ARL-at-UH/Wave_Flume_DAQ/docs/wave_flume_daq_schematic.pdf

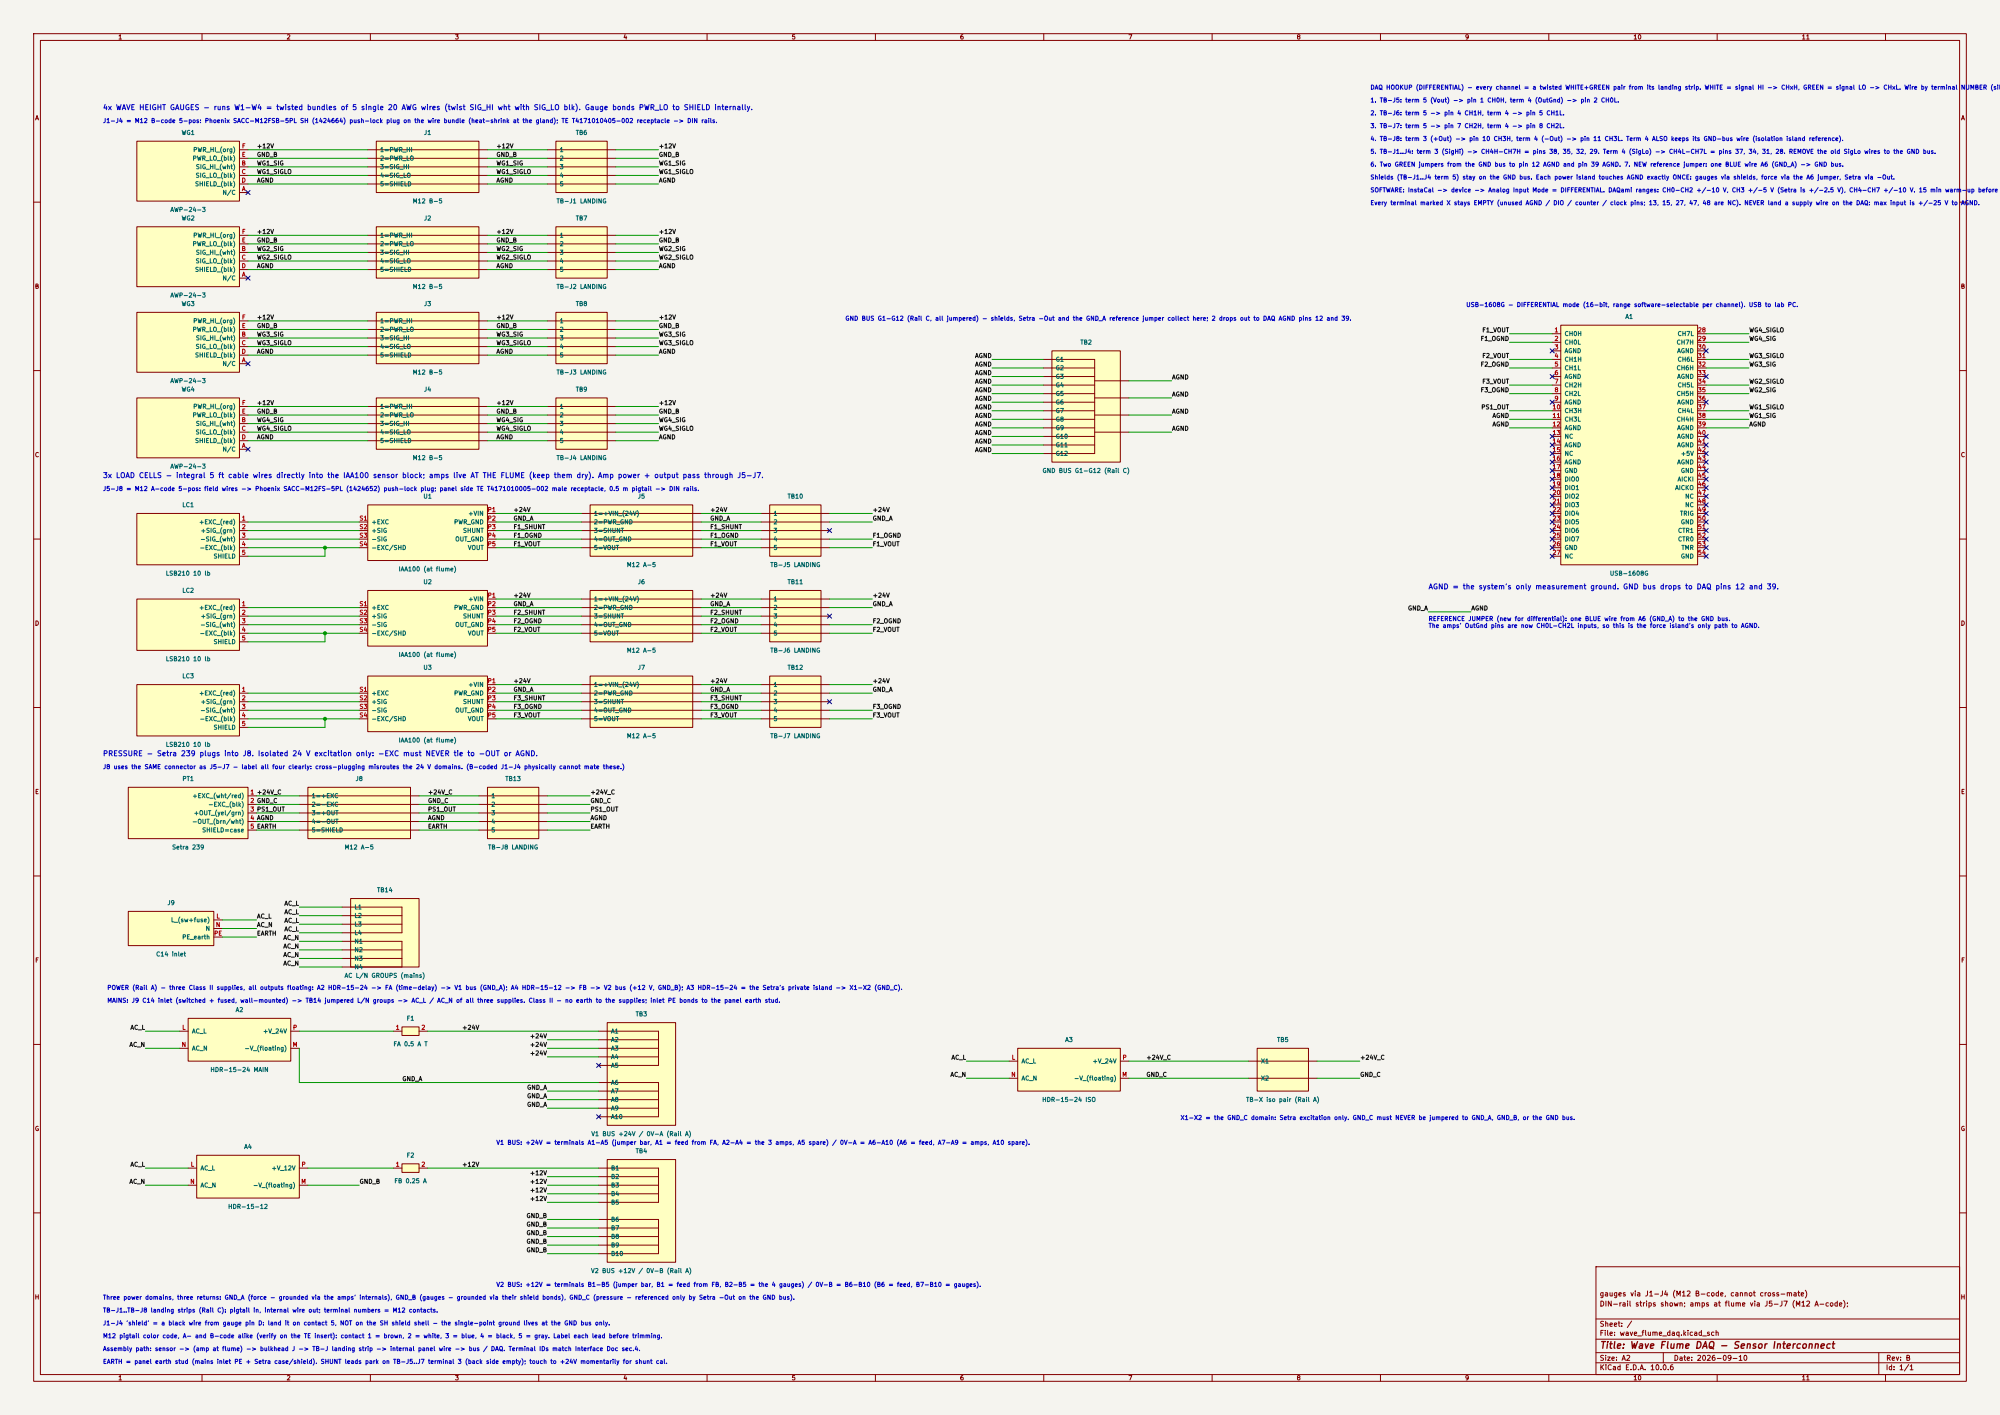
[picture p2: page 1]

Shields (TB-J1..J4 term 5) stay on the GND bus. Each power island touches AGND exactly ONCE: gauges via shields, force via the A6 jumper, Setra via -Out. DAQ HOOKUP (DIFFERENTIAL) - every channel = a twisted WHITE+GREEN pair from its landing strip. WHITE = signal HI -> CHxH, GREEN = signal LO -> CHxL. Wire by terminal NUMBER (silkscreen shows single-ended names).

1. TB-J5: term 5 (Vout) -> pin 1 CH0H, term 4 (OutGnd) -> pin 2 CH0L. 6. Two GREEN jumpers from the GND bus to pin 12 AGND and pin 39 AGND. 7. NEW reference jumper: one BLUE wire A6 (GND_A) -> GND bus.

4x WAVE HEIGHT GAUGES - runs W1-W4 = twisted bundles of 5 single 20 AWG wires (twist SIG_HI wht with SIG_LO blk). Gauge bonds PWR_LO to SHIELD internally.
J1-J4 = M12 B-code 5-pos: Phoenix SACC-M12FSB-5PL SH (1424664) push-lock plug on the wire bundle (heat-shrink at the gland); TE T4171010405-002 receptacle -> DIN rails. 3x LOAD CELLS - integral 5 ft cable wires directly into the IAA100 sensor block; amps live AT THE FLUME (keep them dry). Amp power + output pass through J5-J7.

3. TB-J7: term 5 -> pin 7 CH2H, term 4 -> pin 8 CH2L.

J1 M12 B-5 1=PWR_HI 2=PWR_LO | GND_B | 2

4. TB-J8: term 3 (+Out) -> pin 10 CH3H, term 4 (-Out) -> pin 11 CH3L. Term 4 ALSO keeps its GND-bus wire (isolation island reference).

SOFTWARE: InstaCal -> device -> Analog Input Mode = DIFFERENTIAL. DAQami ranges: CH0-CH2 +/-10 V, CH3 +/-5 V (Setra is +/-2.5 V), CH4-CH7 +/-10 V. 15 min warm-up before calibrated readings. 5. TB-J1..J4: term 3 (SigHi) -> CH4H-CH7H = pins 38, 35, 32, 29. Term 4 (SigLo) -> CH4L-CH7L = pins 37, 34, 31, 28. REMOVE the old SigLo wires to the GND bus. Every terminal marked X stays EMPTY (unused AGND / DIO / counter / clock pins; 13, 15, 27, 47, 48 are NC). NEVER land a supply wire on the DAQ: max input is +/-25 V to AGND.

WG1_SIG

USB-1608G - DIFFERENTIAL mode (16-bit, range software-selectable per channel). USB to lab PC.

J4 M12 B-5 1=PWR_HI 2=PWR_LO | GND_B | 2

WG4_SIG

PRESSURE - Setra 239 plugs into J8. Isolated 24 V excitation only: -EXC must NEVER tie to -OUT or AGND. MAINS: J9 C14 inlet (switched + fused, wall-mounted) -> TB14 jumpered L/N groups -> AC_L / AC_N of all three supplies. Class II - no earth to the supplies; inlet PE bonds to the panel earth stud.

J8 uses the SAME connector as J5-J7 - label all four clearly: cross-plugging misroutes the 24 V domains. (B-coded J1-J4 physically cannot mate these.)

PS1_OUT +24V_C GND_C | J8 M12 A-5 2=-EXC | PS1_OUT GND_C | 2 | GND_C +24V_C

AGND | 3=+OUT 4=-OUT 5=SHIELD | 4

EARTH

POWER (Rail A) - three Class II supplies, all outputs floating: A2 HDR-15-24 -> FA (time-delay) -> V1 bus (GND_A); A4 HDR-15-12 -> FB -> V2 bus (+12 V, GND_B); A3 HDR-15-24 = the Setra's private island -> X1-X2 (GND_C).

TB-X iso pair (Rail A)

X1-X2 = the GND_C domain: Setra excitation only. GND_C must NEVER be jumpered to GND_A, GND_B, or the GND bus.

V1 BUS: +24V = terminals A1-A5 (jumper bar, A1 = feed from FA, A2-A4 = the 3 amps, A5 spare) / 0V-A = A6-A10 (A6 = feed, A7-A9 = amps, A10 spare).

V2 BUS: +12V = terminals B1-B5 (jumper bar, B1 = feed from FB, B2-B5 = the 4 gauges) / 0V-B = B6-B10 (B6 = feed, B7-B10 = gauges).

TB-J1..TB-J8 landing strips (Rail C): pigtail in, internal wire out; terminal numbers = M12 contacts. M12 pigtail color code, A- and B-code alike (verify on the TE insert): contact 1 = brown, 2 = white, 3 = blue, 4 = black, 5 = gray. Label each lead before trimming. EARTH = panel earth stud (mains inlet PE + Setra case/shield). SHUNT leads park on TB-J5..J7 terminal 3 (back side empty); touch to +24V momentarily for shunt cal. Three power domains, three returns: GND_A (force - grounded via the amps' internals), GND_B (gauges - grounded via their shield bonds), GND_C (pressure - referenced only by Setra -Out on the GND bus).

gauges via J1-J4 (M12 B-code, cannot cross-mate)
DIN-rail strips shown; amps at flume via J5-J7 (M12 A-code);

J1-J4 'shield' = a black wire from gauge pin D: land it on contact 5, NOT on the SH shield shell - the single-point ground lives at the GND bus only.

Sheet: /
File: wave_flume_daq.kicad_sch
Title: Wave Flume DAQ - Sensor Interconnect

Assembly path: sensor -> (amp at flume) -> bulkhead J -> TB-J landing strip -> internal panel wire -> bus / DAQ. Terminal IDs match Interface Doc sec.4.

Size: A2 | Rev: B
KiCad E.D.A. 10.0.6 | Id: 1/1
