ARL-at-UH/Wave_Flume_DAQ/ref/DAQ_Sketch.pdf

# 風 。感器Hi

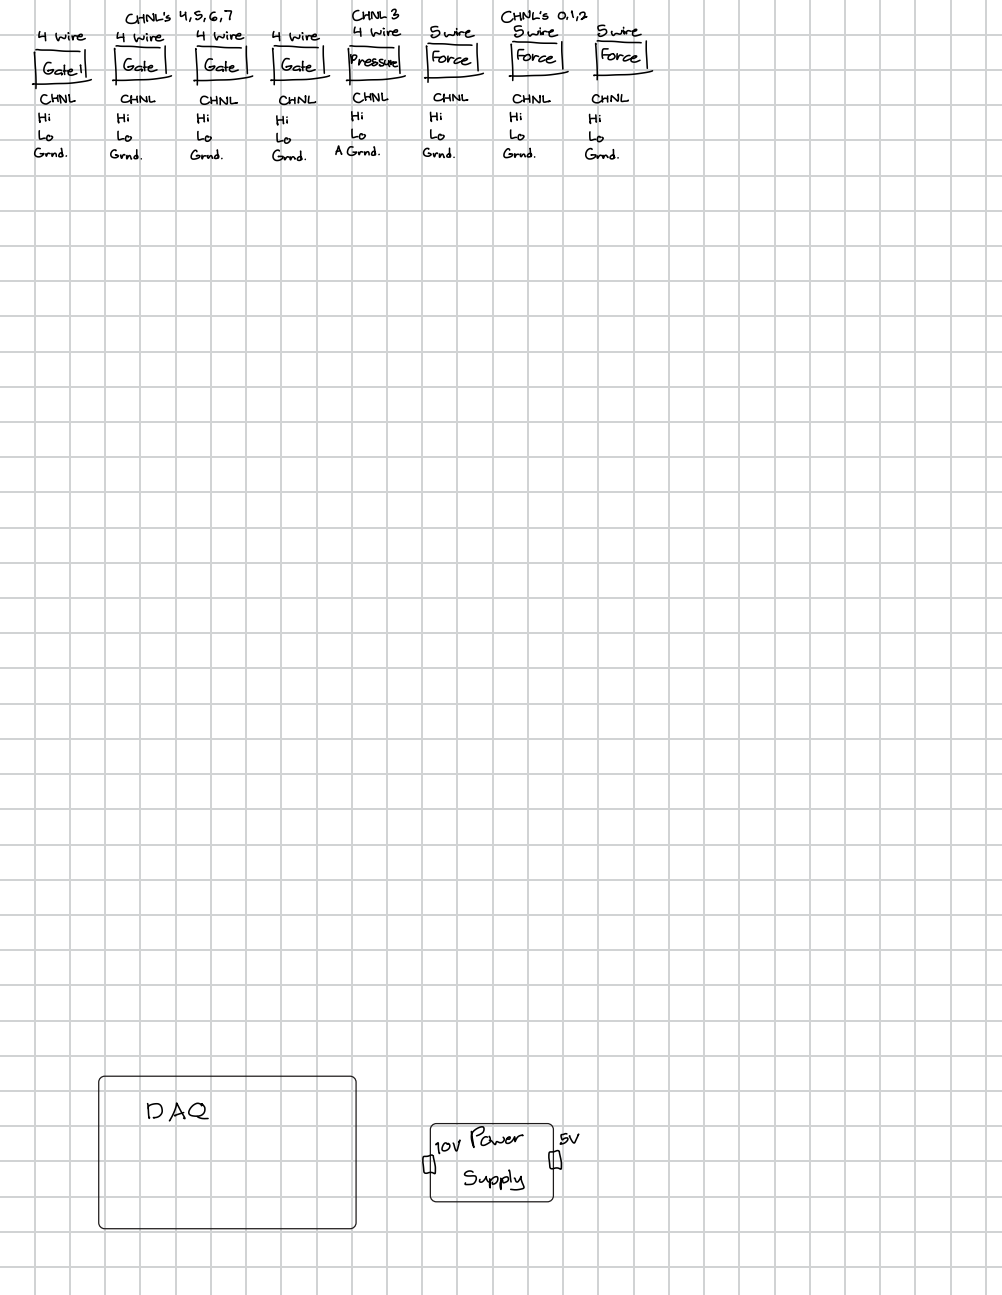
[picture p3: page 1]
CHNL; 1 CHNL's; CHNL's; 風⑩Hi; 籔 品Hi; 母Hi; 봉 Gund.; Grnd .; Gund.; A Gund .
