ARL-at-UH/Wave_Flume_DAQ/(commit log)

2026-10-17 Restructure docs and update to as-built config
    - docs/procedures/: panel wiring, software setup, shunt calibration
    - docs/debug/: noise debugging (moved from noise_debug_checklist.md)
    - docs/index.html: full ICD for GitHub Pages hosting (Rev C, V32)
    - Schematic: as-built channels/colors, 6-pos GND bus, net renames
    - README: repo map + project site section
    - ref/: add FUTEK DAQ-amp pairing guide
    [wave_flume_daq.kicad_sch]
2026-10-19 Direct KiCanvas link + copyable schematic URL, drop student wording
2026-10-19 Comment out schematic embed until SVGs are exported
2026-10-19 update wire colors and documentation for real install
    [BOM.csv, wave_flume_daq.kicad_sch]
2026-10-19 Rev D as-built update + docs polish
    - Schematic + ICD updated to as-built panel (LC/PT names, common M12
    scheme, three-row layout, yellow=12V / orange=ISO)
    - Procedures rewritten to as-built terminals; shunt now term 5
    - ICD figures: overlap fixes, explicit text fills, high-contrast background
    - Removed read-first banners; full-width text; GitHub <-> docs cross-links
2026-10-19 clean up text in docs
    [wave_flume_daq.kicad_sch]
